rhit-bryantlj/PanamaCityBeach/(commit log)

2022-04-05 drives in a circle
    -changed simple servo to take input from the serial monitor
    -car goes in a circle now
2022-04-21 code and data for two minute run for speed 60 and 65
    [Two_minute_65_speed.csv]
2022-04-25 line following code fixes
    partially fixed oversteer issues. Could use some more refinement.
    [followLine_w_power_reporting.ino, simple_servos.ino]
2022-04-27 Added support for faster speeds on straightaways
    Bluetooth speed commands now only affect the speed the car goes while going straight. Additionally, 67 /67 was found the be the best speed for the car.
    70 is too fast. 68 and 69 have not been tested.
    [followLine_w_power_reporting.ino]
2022-04-27 Created python editing script and produced power excel sheets
    [Two_minute_65_speed.xlsx, fig8_67straight_67curve_10.8laps.xlsx, fig8_68straight_65curve_9.5laps.xlsx]
2022-04-27 consolidate power stuff into one folder
    [Oval_65straight_65curve_speed.xlsx, Two_minute_65_speed.csv]
2022-05-09 added remote speed adjustment capabilities
    You can now control the straightaway and turning speed live from the bluetooth terminal.
    How to use:
    66t - set turning speed to 66
    70s - set turning speed to 70
    the car has been seen doing 10 laps in two minutes around the figure 8 track using the settings above.
2022-05-15 power data additions made
    [fig8_67straight_67curve_10.8laps.xlsx]
